astrolemonade/Goose-Belt-Purger/Assets/V2.4/image (1).jpg

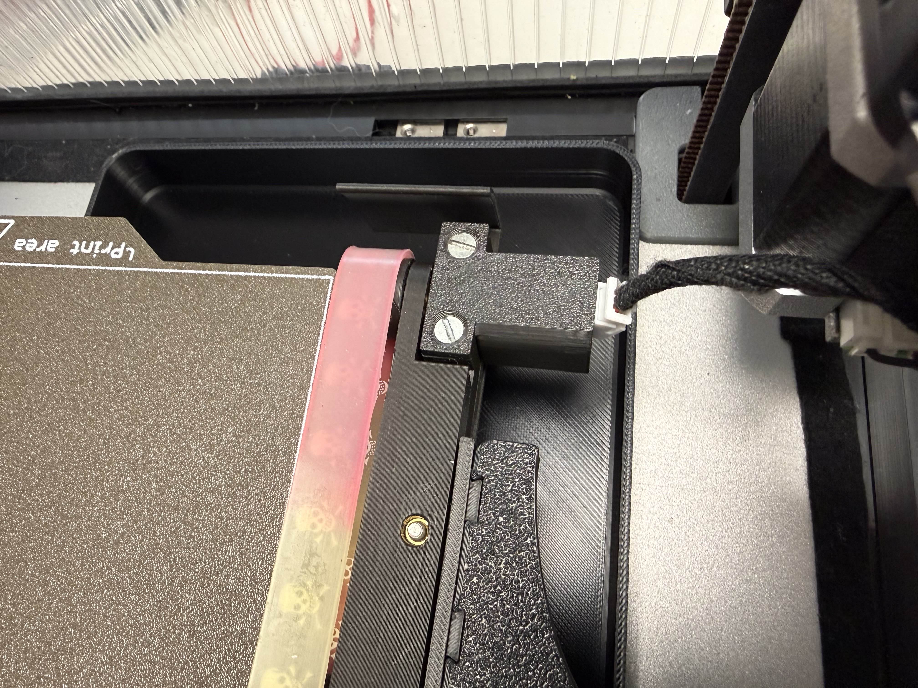
Assets/V2.4/image (1).jpg
