astrolemonade/Goose-Belt-Purger/Assets/V2.4/image (2).jpg

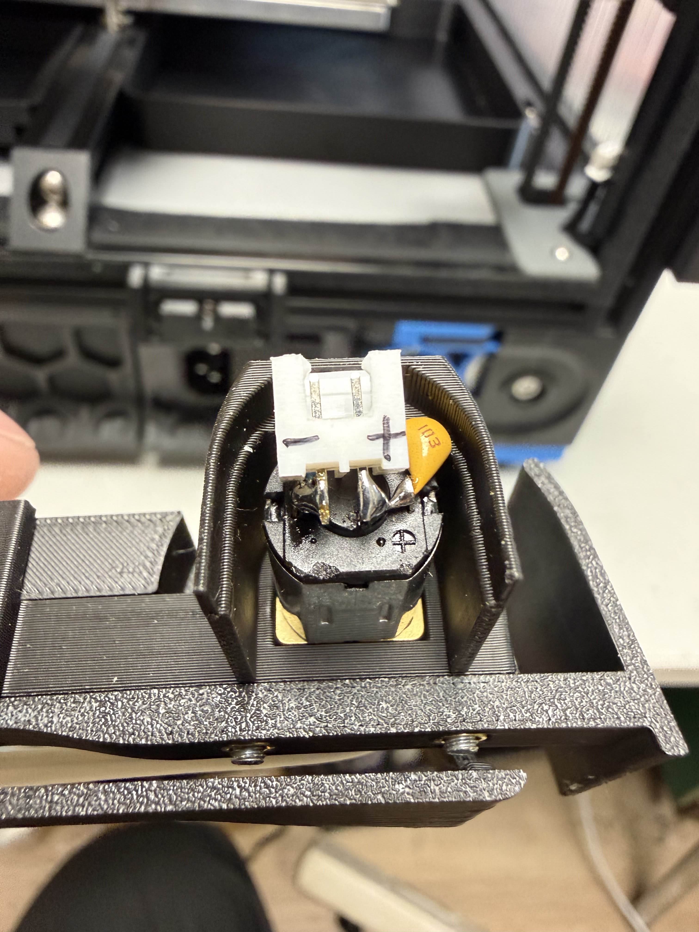
Assets/V2.4/image (2).jpg
