astrolemonade/Goose-Belt-Purger/Assets/V2.4/image (3).jpg

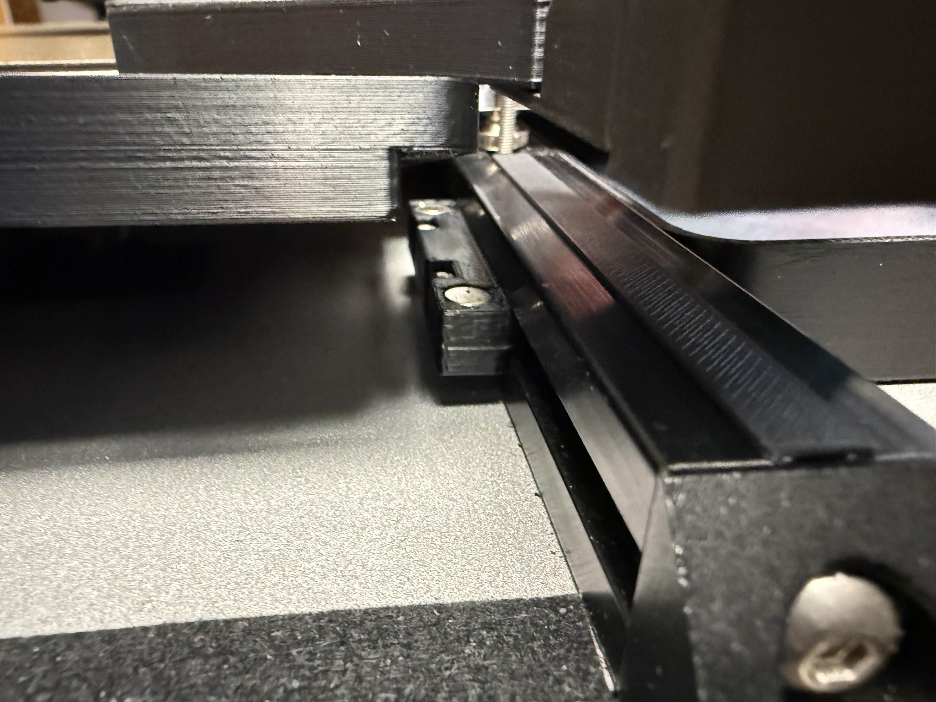
Assets/V2.4/image (3).jpg
