astrolemonade/Goose-Belt-Purger/Assets/V2.4/image (4).jpg

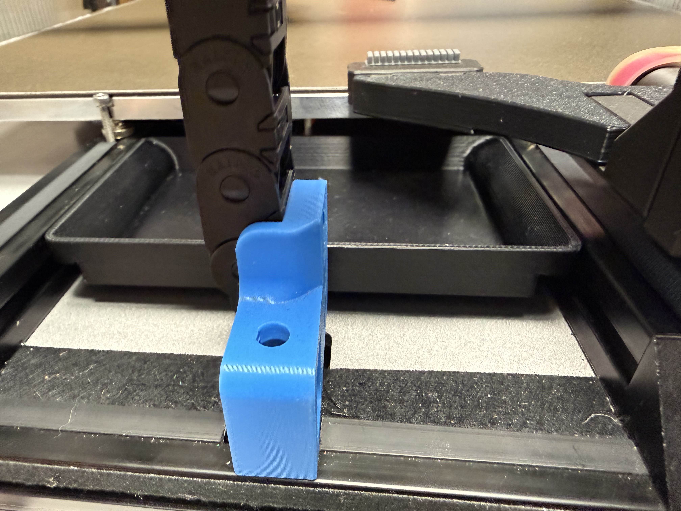
Assets/V2.4/image (4).jpg
