astrolemonade/Goose-Belt-Purger/Assets/V2.4/image (6).jpg

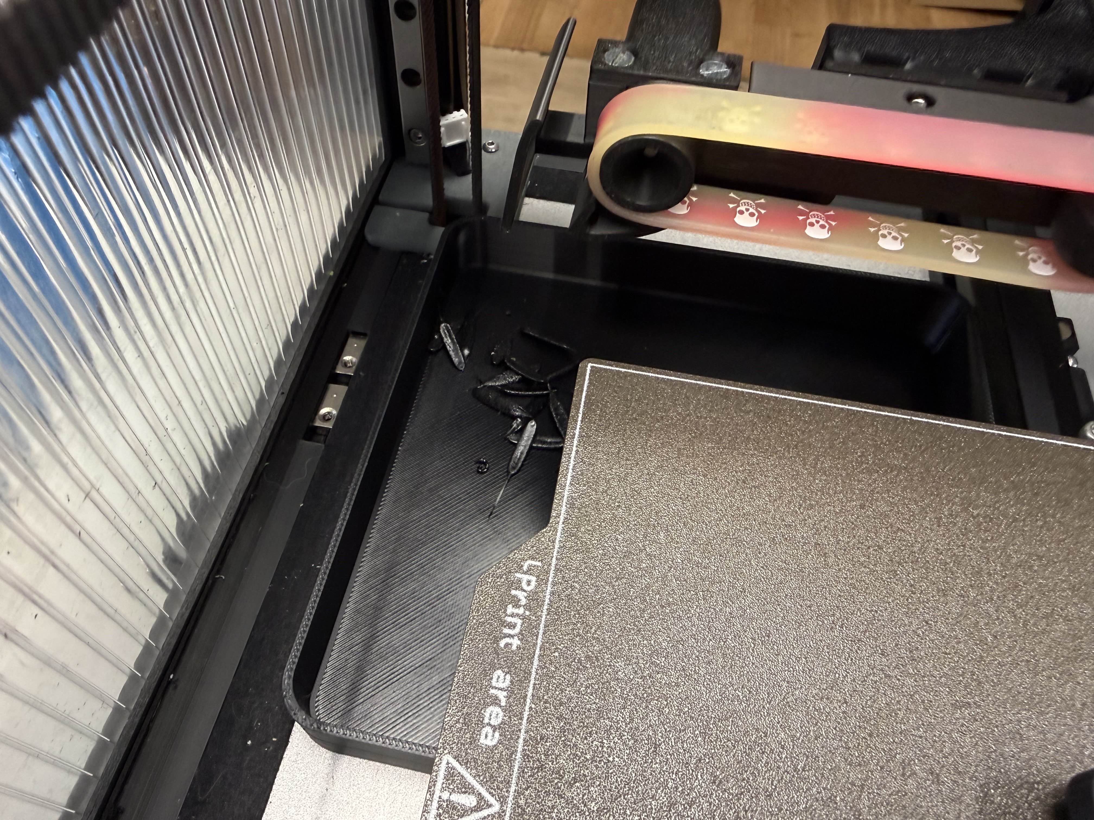
Assets/V2.4/image (6).jpg
