astrolemonade/Goose-Belt-Purger/Assets/V2.4/image (7).jpg

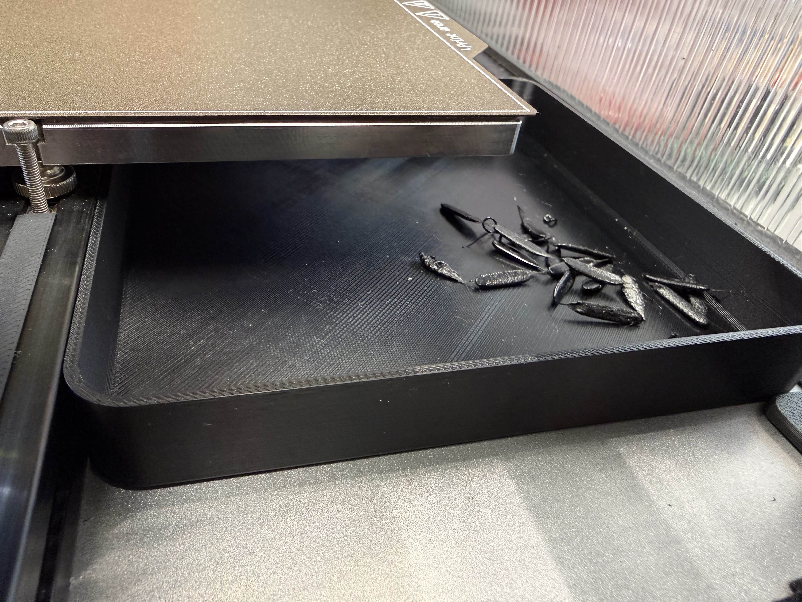
Assets/V2.4/image (7).jpg
