astrolemonade/Goose-Belt-Purger/Assets/V2.4/image (8).jpg

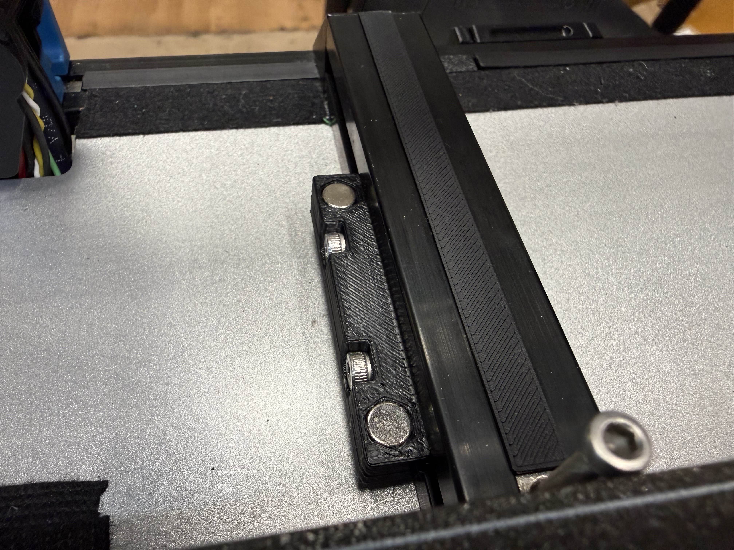
Assets/V2.4/image (8).jpg
