astrolemonade/Goose-Belt-Purger/Assets/V2.4/image (9).jpg

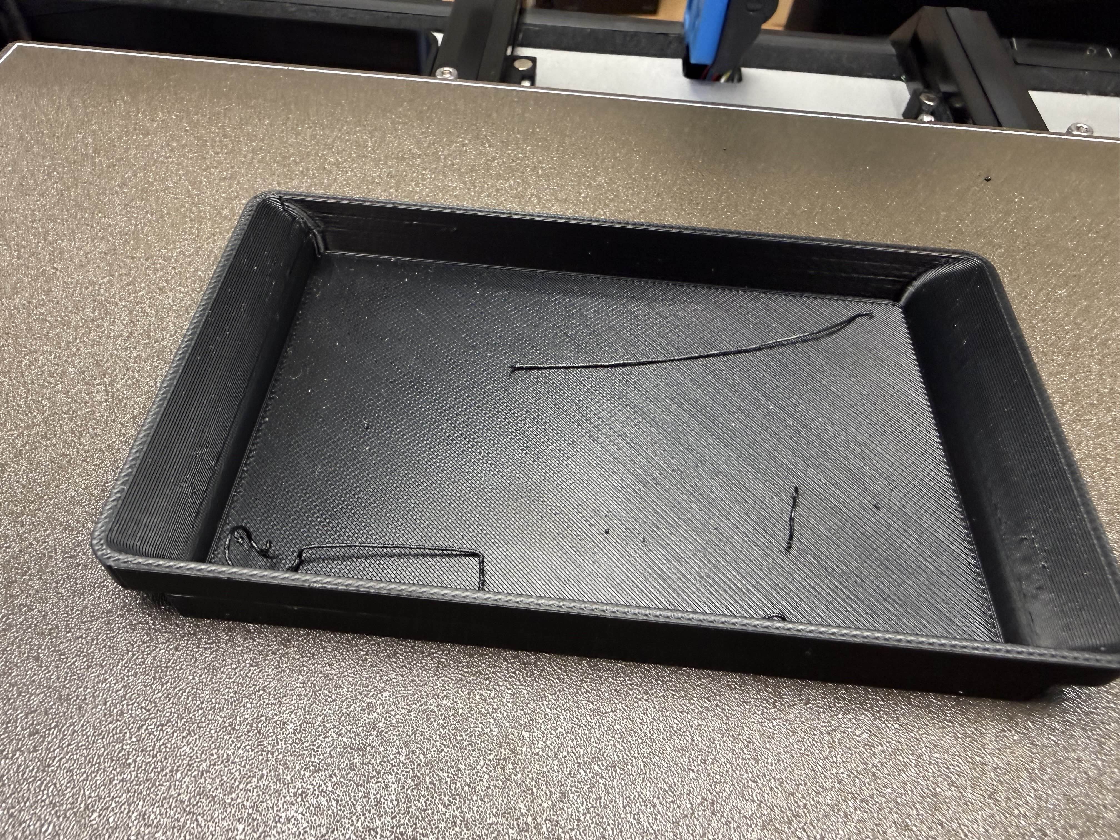
Assets/V2.4/image (9).jpg
