astrolemonade/Goose-Belt-Purger/Assets/V2.4/image (10).jpg

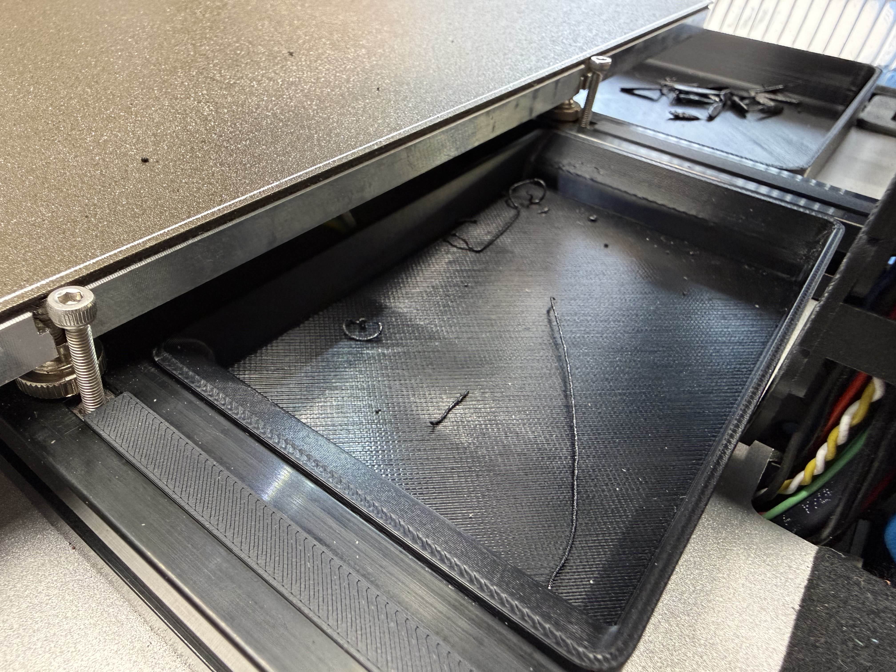
Assets/V2.4/image (10).jpg
