astrolemonade/Goose-Belt-Purger/Assets/V2.4/image.jpg

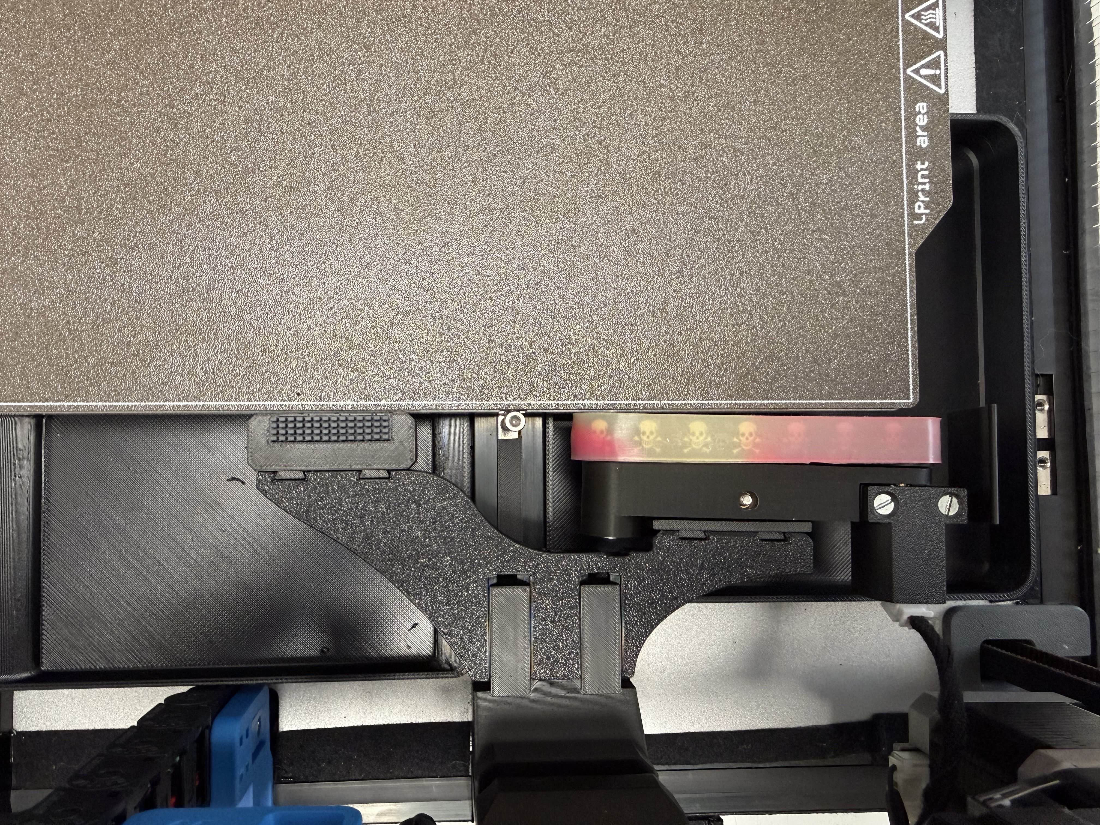
Assets/V2.4/image.jpg
