astrolemonade/Goose-Belt-Purger/User_mods/Dragi2k/Alternative_v2.4_mount/image.png

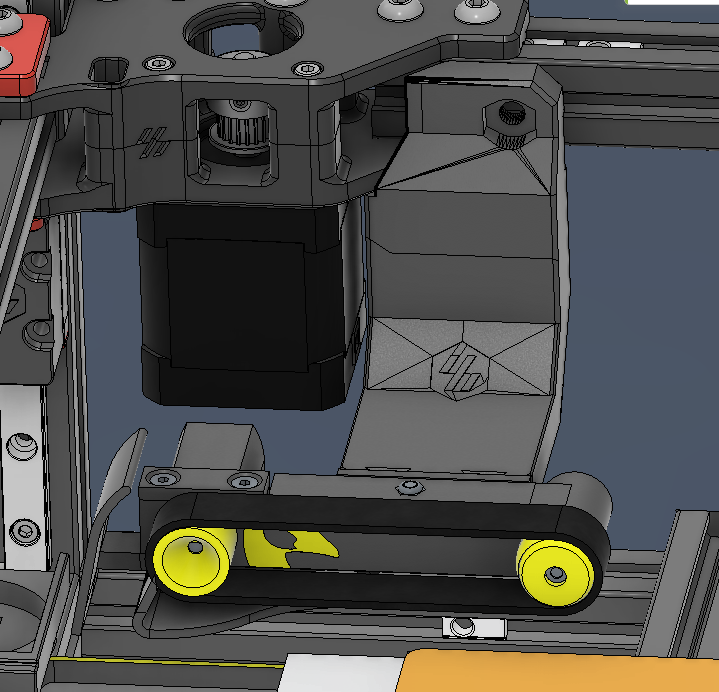
User_mods/Dragi2k/Alternative_v2.4_mount/image.png
