astrolemonade/Goose-Belt-Purger/STEP+STL_(Parts)/STL/01_Mounts/AT_Style-Voron_Trident+2.4/README.md

Modified version of AT Brush mount, suitable for Voron Trident and Voron 2.4.  
  
Based on: AT_Brush (Published under GPL-3) - Credit goes to ArmoredTurtle team

V2.4 offseted mount designed by AmfKuna
