astrolemonade/Goose-Belt-Purger/STEP+STL_(Parts)/STEP/01_Mounts/AT_Style-Voron_Trident+2.4/ATmount_front_arm_slide_V2.4_offset.step

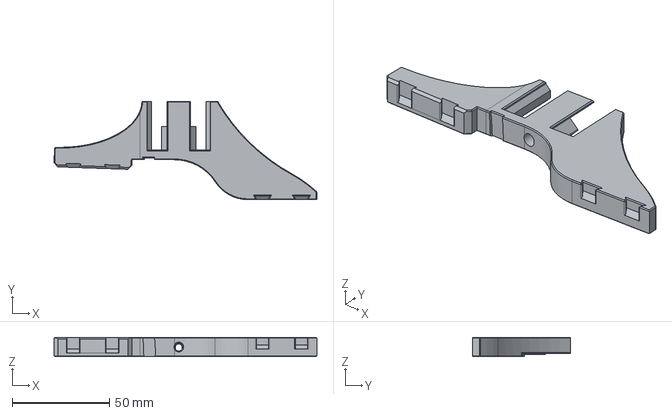
[picture p16: CAD file, 2025-10-19]
STEP+STL_(Parts)/STEP/01_Mounts/AT_Style-Voron_Trident+2.4/ATmount_front_arm_slide_V2.4_offset.step
135.1 x 50.5 x 10.0 mm
