astrolemonade/Goose-Belt-Purger/STEP+STL_(Parts)/STEP/02_Alternative_parts/GBP_Deflector_lite.step

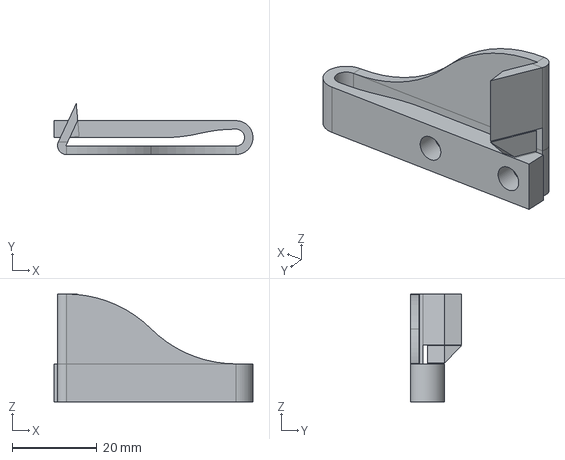
[picture p17: CAD file, 2025-10-06]
STEP+STL_(Parts)/STEP/02_Alternative_parts/GBP_Deflector_lite.step
47.0 x 12.1 x 25.5 mm
