astrolemonade/Goose-Belt-Purger/STEP+STL_(Parts)/STEP/06_Buckets/V2.4_Rear_access/bucket_V2.4-300.step

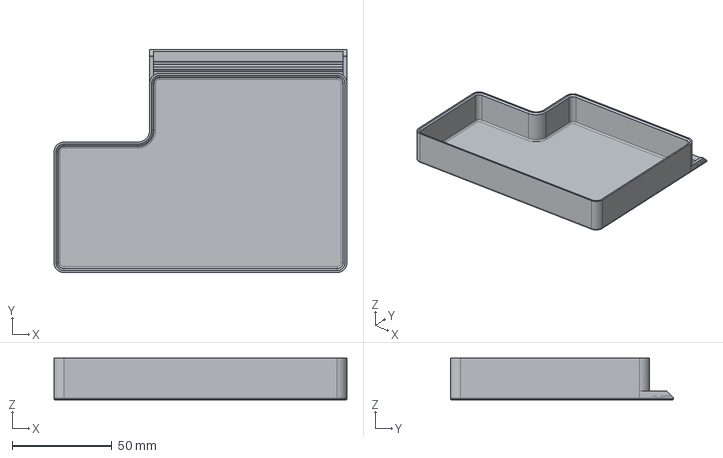
[picture p19: CAD file, 2025-10-06]
STEP+STL_(Parts)/STEP/06_Buckets/V2.4_Rear_access/bucket_V2.4-300.step
147.0 x 112.0 x 21.0 mm
