astrolemonade/Goose-Belt-Purger/STEP+STL_(Parts)/STEP/GBP_Deflector.step

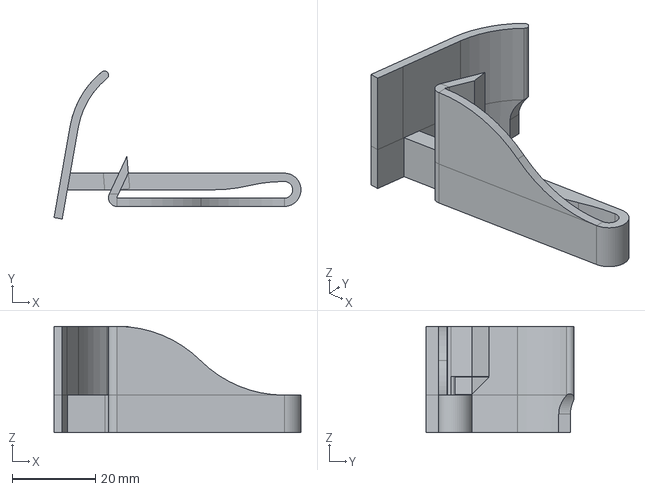
[picture p20: CAD file, 2025-10-06]
STEP+STL_(Parts)/STEP/GBP_Deflector.step
59.2 x 35.5 x 25.5 mm
