astrolemonade/Goose-Belt-Purger/STEP+STL_(Parts)/STL/01_Mounts/AT_Style-Voron_Trident+2.4/ATmount_front_arm_base_(GBP).stl

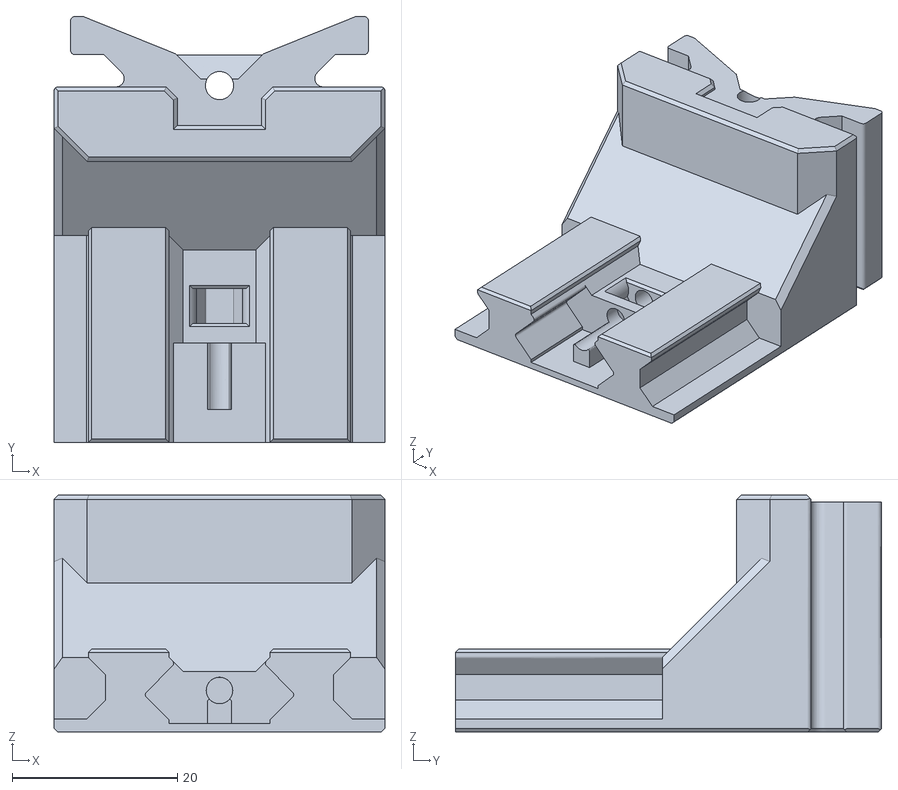
[picture p21: CAD file, 2025-10-06]
STEP+STL_(Parts)/STL/01_Mounts/AT_Style-Voron_Trident+2.4/ATmount_front_arm_base_(GBP).stl
40.0 x 51.5 x 28.6
