astrolemonade/Goose-Belt-Purger/STEP+STL_(Parts)/STL/06_Buckets/V2.4/V2.4_Center/center_bucket.stl

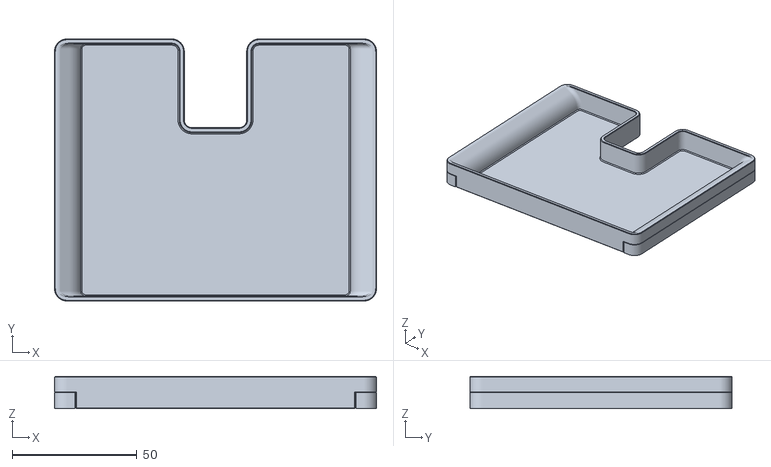
[picture p22: CAD file, 2025-10-19]
STEP+STL_(Parts)/STL/06_Buckets/V2.4/V2.4_Center/center_bucket.stl
129.0 x 105.0 x 13.0
