astrolemonade/Goose-Belt-Purger/STEP+STL_(Parts)/STL/06_Buckets/V2.4_Front_access/GBP_bucket_V2.4-300_front.stl

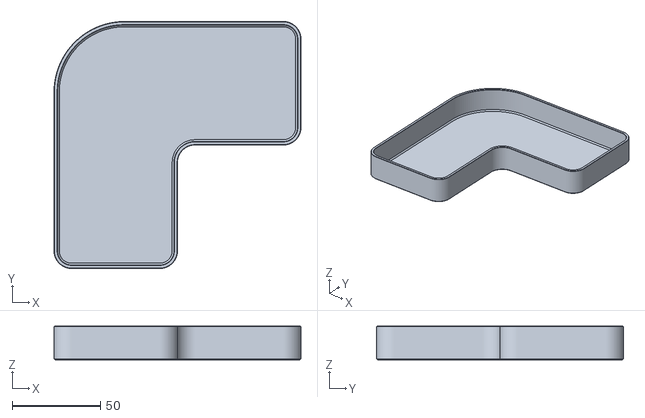
[picture p23: CAD file, 2025-10-06]
STEP+STL_(Parts)/STL/06_Buckets/V2.4_Front_access/GBP_bucket_V2.4-300_front.stl
140.0 x 140.0 x 19.0
