astrolemonade/Goose-Belt-Purger/User_mods/Dragi2k/Alternative_v2.4_mount/V2.4 AT mount side mod.stl

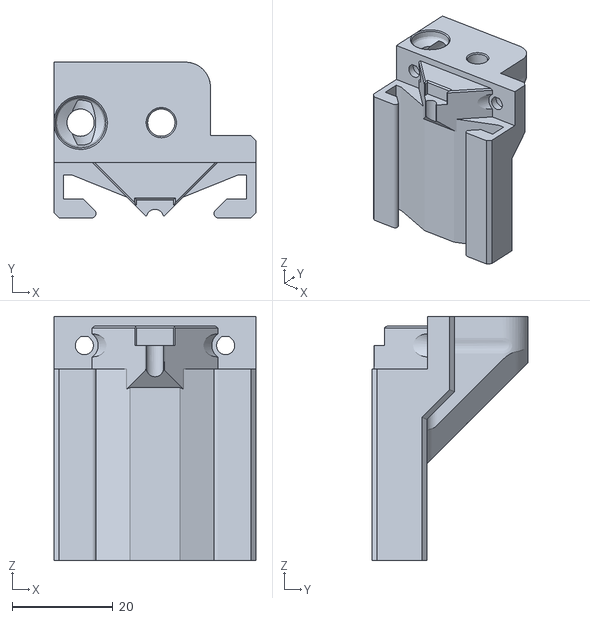
[picture p24: CAD file, 2025-10-19]
User_mods/Dragi2k/Alternative_v2.4_mount/V2.4 AT mount side mod.stl
40.0 x 30.9 x 48.4
