astrolemonade/Goose-Belt-Purger/User_mods/Sakitume/MotorPulley/GBP_Motor_Pulley_4mmBHCS.stl

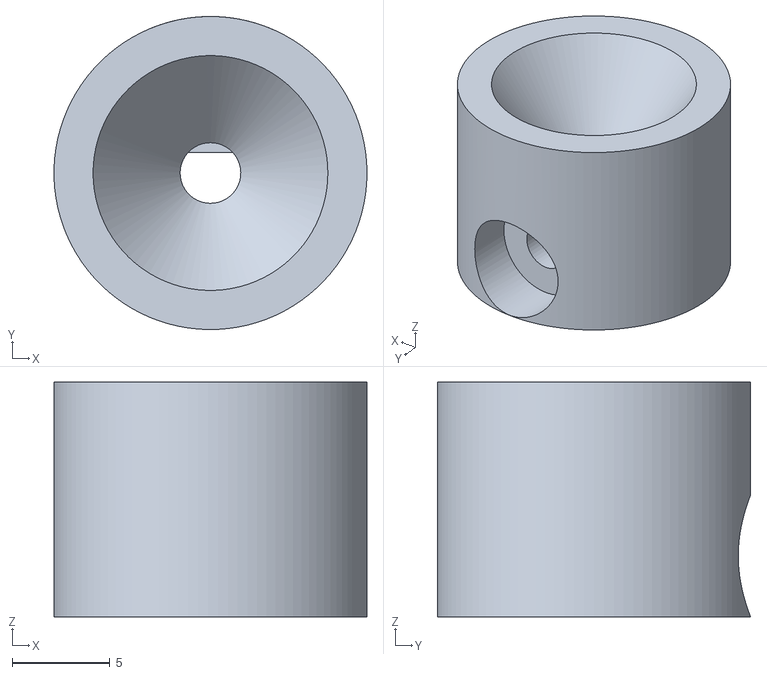
[picture p25: CAD file, 2025-12-23]
User_mods/Sakitume/MotorPulley/GBP_Motor_Pulley_4mmBHCS.stl
16.0 x 16.0 x 12.0
