astrolemonade/Goose-Belt-Purger/User_mods/Sakitume/TPU_Belt/Deflector_short_thin_belt.stl

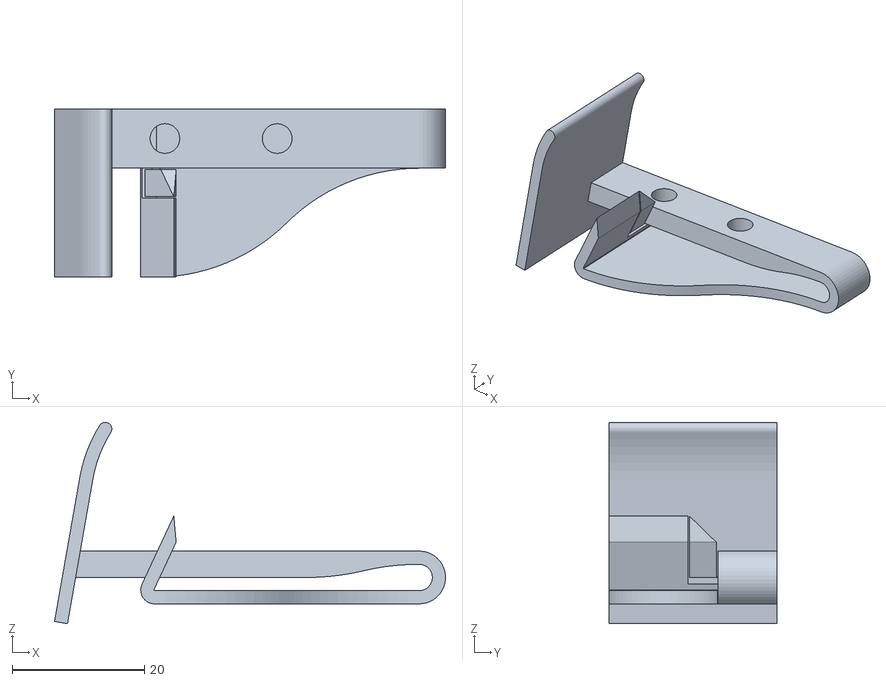
[picture p26: CAD file, 2025-12-23]
User_mods/Sakitume/TPU_Belt/Deflector_short_thin_belt.stl
59.2 x 25.5 x 30.5
