astrolemonade/Goose-Belt-Purger/STEP+STL_(Parts)/STEP/01_Mounts/AT_Style-Voron_Trident+2.4/ATmount_front_arm_slide_Trident_offset.step

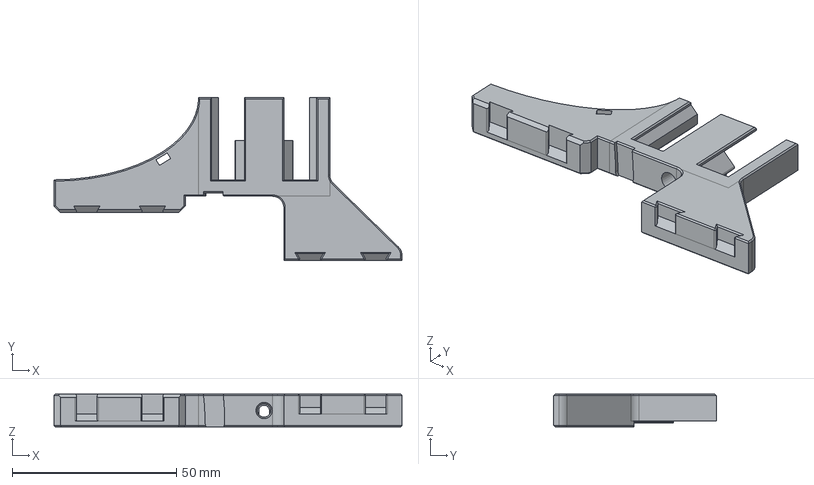
[picture p27: CAD file, 2025-10-06]
STEP+STL_(Parts)/STEP/01_Mounts/AT_Style-Voron_Trident+2.4/ATmount_front_arm_slide_Trident_offset.step
106.0 x 49.5 x 10.0 mm
