astrolemonade/Goose-Belt-Purger/STEP+STL_(Parts)/STEP/06_Buckets/Trident/bucket_Trident-350.step

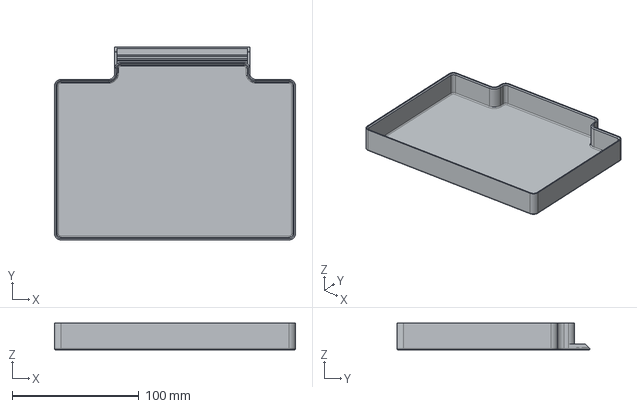
[picture p28: CAD file, 2025-10-06]
STEP+STL_(Parts)/STEP/06_Buckets/Trident/bucket_Trident-350.step
190.0 x 152.0 x 21.0 mm
