astrolemonade/Goose-Belt-Purger/STEP+STL_(Parts)/STL/01_Mounts/AT_Style-Voron_Trident+2.4/ATmount_lower_(GBP).stl

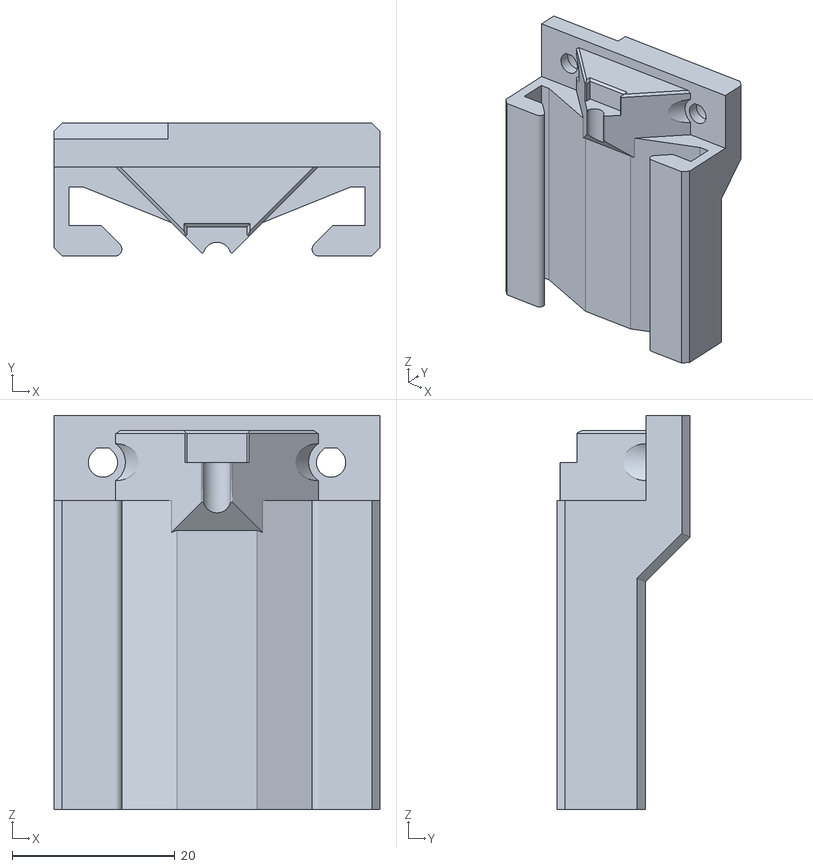
[picture p29: CAD file, 2025-10-06]
STEP+STL_(Parts)/STL/01_Mounts/AT_Style-Voron_Trident+2.4/ATmount_lower_(GBP).stl
40.0 x 16.4 x 48.4
