astrolemonade/Goose-Belt-Purger/STEP+STL_(Parts)/STL/06_Buckets/V2.4_Front_access/GBP_bucket_V2.4-250_front.stl

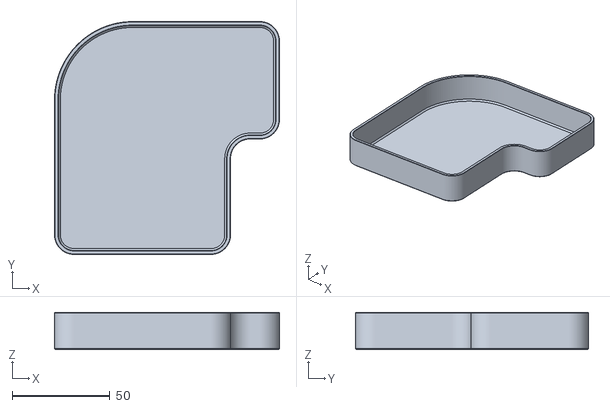
[picture p30: CAD file, 2025-10-06]
STEP+STL_(Parts)/STL/06_Buckets/V2.4_Front_access/GBP_bucket_V2.4-250_front.stl
115.0 x 119.0 x 19.0
