astrolemonade/Goose-Belt-Purger/User_mods/Dragi2k/Alternative_v2.4_mount/300 v2.4 with xol FIX.stl

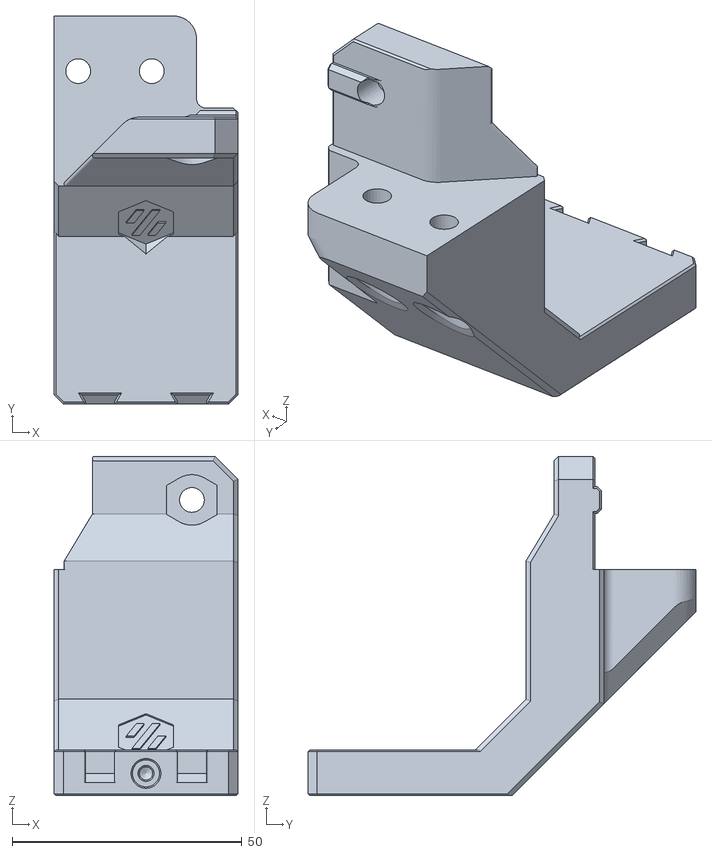
[picture p31: CAD file, 2025-10-19]
User_mods/Dragi2k/Alternative_v2.4_mount/300 v2.4 with xol FIX.stl
40.0 x 84.4 x 73.9
