astrolemonade/Goose-Belt-Purger/User_mods/Sakitume/TPU_Belt/TPU_Belt.stl

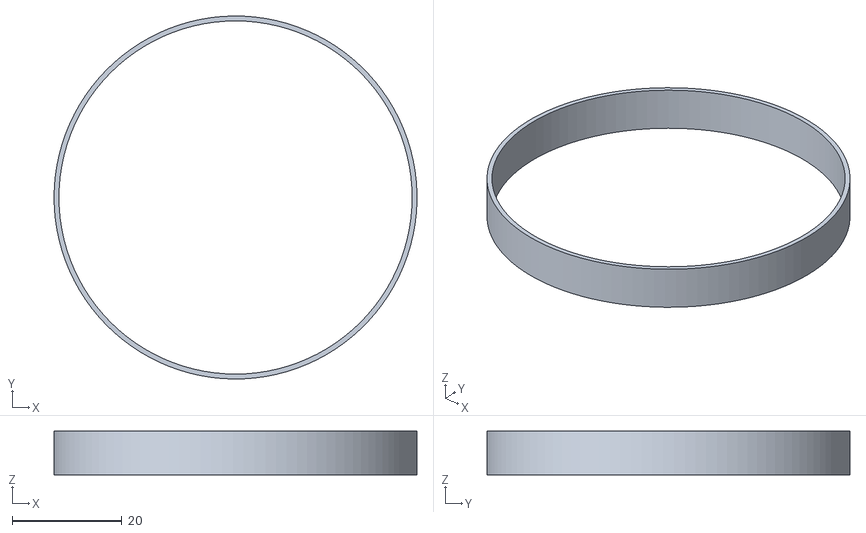
[picture p32: CAD file, 2025-12-23]
User_mods/Sakitume/TPU_Belt/TPU_Belt.stl
66.1 x 66.1 x 8.00
