astrolemonade/Goose-Belt-Purger/STEP+STL_(Parts)/STEP/02_Alternative_parts/GBP_Deflector_long_noinserts.step

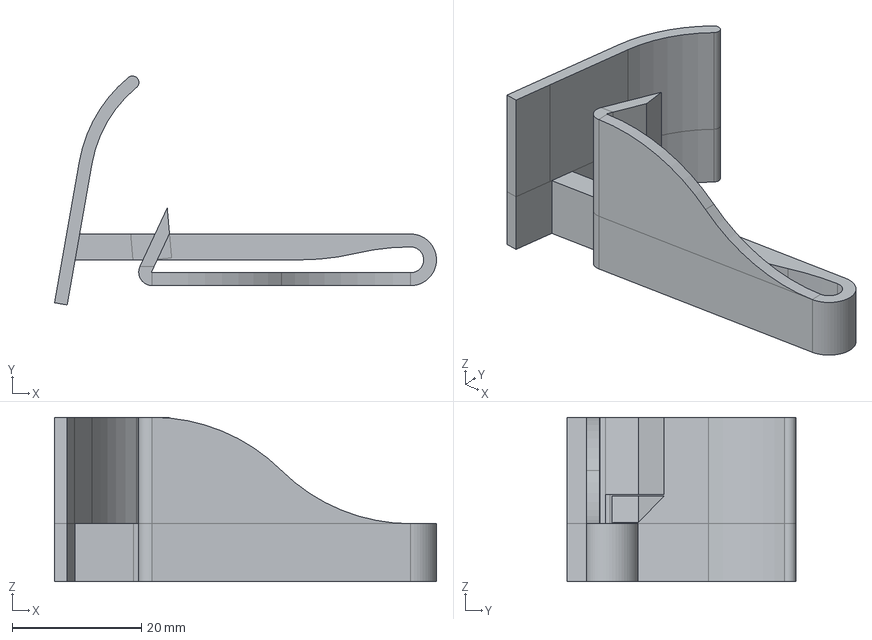
[picture p33: CAD file, 2025-10-06]
STEP+STL_(Parts)/STEP/02_Alternative_parts/GBP_Deflector_long_noinserts.step
59.2 x 35.5 x 25.5 mm
