astrolemonade/Goose-Belt-Purger/STEP+STL_(Parts)/STEP/06_Buckets/Trident/bucket_clamp_(FHCS)_x2.step

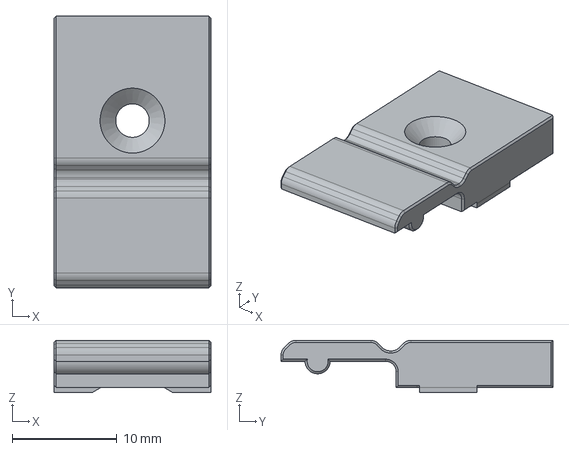
[picture p34: CAD file, 2025-10-06]
STEP+STL_(Parts)/STEP/06_Buckets/Trident/bucket_clamp_(FHCS)_x2.step
15.0 x 26.0 x 5.00 mm
