astrolemonade/Goose-Belt-Purger/STEP+STL_(Parts)/STL/01_Mounts/AT_Style-Voron_Trident+2.4/ATmount_front_arm_slide_(GBP).stl

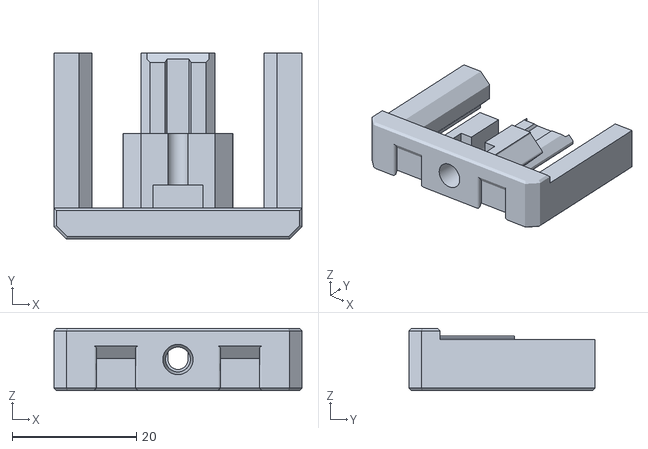
[picture p36: CAD file, 2025-10-06]
STEP+STL_(Parts)/STL/01_Mounts/AT_Style-Voron_Trident+2.4/ATmount_front_arm_slide_(GBP).stl
40.0 x 30.0 x 10.0
