astrolemonade/Goose-Belt-Purger/STEP+STL_(Parts)/STL/01_Mounts/AT_Style-Voron_Trident+2.4/ATmount_upper_(GBP).stl

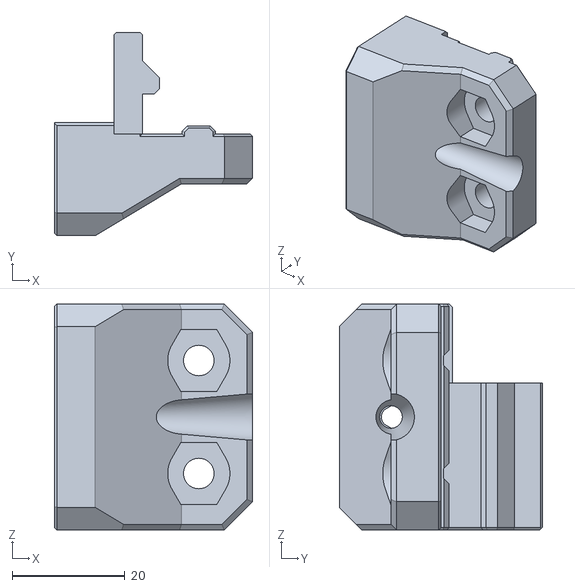
[picture p38: CAD file, 2025-10-06]
STEP+STL_(Parts)/STL/01_Mounts/AT_Style-Voron_Trident+2.4/ATmount_upper_(GBP).stl
35.0 x 36.0 x 40.0
