astrolemonade/Goose-Belt-Purger/STEP+STL_(Parts)/STEP/02_Alternative_parts/GBP_Deflector_short.step

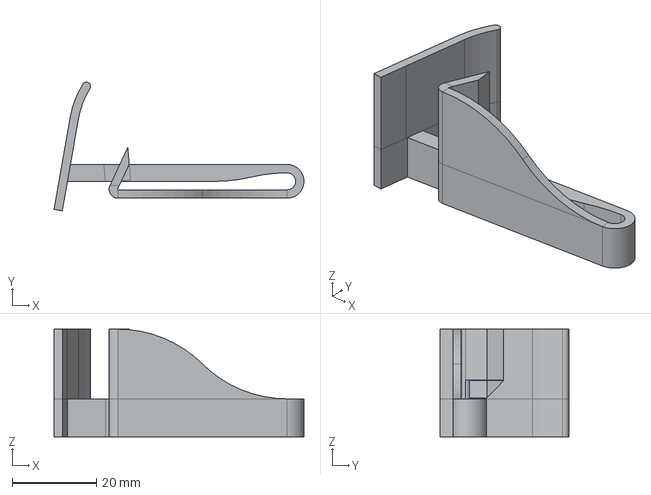
[picture p39: CAD file, 2025-10-06]
STEP+STL_(Parts)/STEP/02_Alternative_parts/GBP_Deflector_short.step
59.2 x 30.5 x 25.5 mm
