astrolemonade/Goose-Belt-Purger/STEP+STL_(Parts)/STEP/06_Buckets/Trident/bucket_Trident-250.step

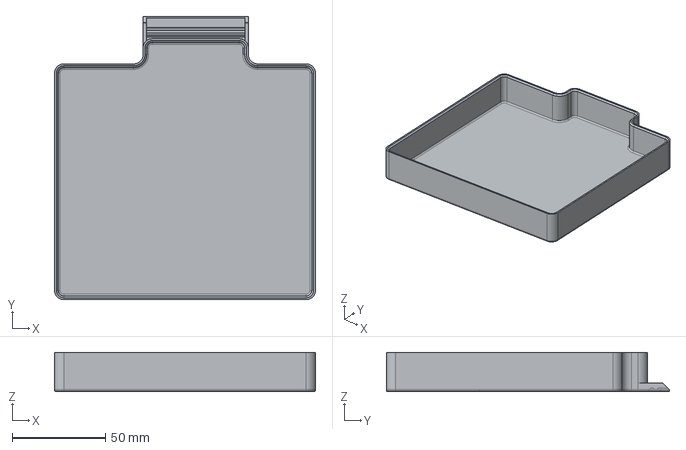
[picture p40: CAD file, 2025-10-06]
STEP+STL_(Parts)/STEP/06_Buckets/Trident/bucket_Trident-250.step
140.0 x 152.0 x 21.0 mm
