astrolemonade/Goose-Belt-Purger/(list of files, cad)

Other CAD files:
STEP+STL_(Parts)/STEP/02_Alternative_parts/GBP_Deflector_lite_noinserts.step
STEP+STL_(Parts)/STEP/06_Buckets/Trident/bucket_clamp_x2.step
STEP+STL_(Parts)/STEP/06_Buckets/V2.4_Rear_access/bucket_clamp_x2.step
STEP+STL_(Parts)/STEP/02_Alternative_parts/GBP_Deflector_short_noinserts.step
STEP+STL_(Parts)/STEP/06_Buckets/V2.4_Rear_access/bucket_V2.4_250.stl
STEP+STL_(Parts)/STEP/06_Buckets/V2.4_Rear_access/bucket_V2.4_300.stl
STEP+STL_(Parts)/STEP/06_Buckets/V2.4_Rear_access/bucket_V2.4_350.stl
STEP+STL_(Parts)/STEP/06_Buckets/V2.4_Rear_access/bucket_V2.stl
STEP+STL_(Parts)/STEP/06_Buckets/V2.4_Rear_access/bucket_clamp_(FHCS)_x2.stl
STEP+STL_(Parts)/STEP/06_Buckets/V2.4_Rear_access/bucket_clamp_x2.stl
STEP+STL_(Parts)/STL/01_Mounts/AT_Style-Voron_Trident+2.4/ATmount_front_arm_slide_Trident_offset.stl
STEP+STL_(Parts)/STL/01_Mounts/AT_Style-Voron_Trident+2.4/ATmount_front_arm_slide_V2.4_offset.stl
STEP+STL_(Parts)/STL/02_Alternative_parts/GBP_Deflector_lite.stl
STEP+STL_(Parts)/STL/02_Alternative_parts/GBP_Deflector_lite_noinserts.stl
STEP+STL_(Parts)/STL/02_Alternative_parts/GBP_Deflector_long.stl
STEP+STL_(Parts)/STL/02_Alternative_parts/GBP_Deflector_long_noinserts.stl
STEP+STL_(Parts)/STL/02_Alternative_parts/GBP_Deflector_short.stl
STEP+STL_(Parts)/STL/02_Alternative_parts/GBP_Deflector_short_noinserts.stl
STEP+STL_(Parts)/STL/06_Buckets/Trident/bucket_Trident-250.stl
STEP+STL_(Parts)/STL/06_Buckets/Trident/bucket_Trident-300.stl
STEP+STL_(Parts)/STL/06_Buckets/Trident/bucket_Trident-350.stl
STEP+STL_(Parts)/STL/06_Buckets/Trident/bucket_clamp_(FHCS)_x2.stl
STEP+STL_(Parts)/STL/06_Buckets/Trident/bucket_clamp_x2.stl
STEP+STL_(Parts)/STL/06_Buckets/V2.4_Rear_access/bucket_V2.4_250.stl
STEP+STL_(Parts)/STL/06_Buckets/V2.4_Rear_access/bucket_V2.4_300.stl
STEP+STL_(Parts)/STL/06_Buckets/V2.4_Rear_access/bucket_V2.4_350.stl
STEP+STL_(Parts)/STL/06_Buckets/V2.4_Rear_access/bucket_clamp_(FHCS)_x2.stl
STEP+STL_(Parts)/STL/06_Buckets/V2.4_Rear_access/bucket_clamp_x2.stl
STEP+STL_(Parts)/STL/GBP_Deflector.stl
User_mods/Sakitume/MotorPulley/GBP_Motor_Pulley_4mmBHCS.f3d
User_mods/Sakitume/TPU_Belt/TPU_Belt.f3d
