astrolemonade/Goose-Belt-Purger/(commit log)

2025-10-06 a012 upload
    [ATmount_front_arm_base_(GBP).stl, ATmount_front_arm_slide_(GBP).stl, ATmount_front_arm_slide_Trident_offseted.step, ATmount_front_arm_slide_Trident_offseted.stl, ATmount_front_arm_slide_V2.4_offseted.stl, ATmount_front_arm_slide_offseted_am04.step, ATmount_lower_(GBP).stl, ATmount_upper_(GBP).stl]
2025-10-10 removal of extra files
    [bucket_Trident-250.stl, bucket_Trident-300.stl, bucket_Trident-350.stl, bucket_V2.4_250.stl, bucket_V2.4_300.stl, bucket_V2.4_350.stl, bucket_V2.stl, bucket_clamp_(FHCS)_x2.stl]
2025-12-10 0.7.3-beta-1
    - Added kickstart
    - Enhanced comments regarding belt_pwm variable
    - Fix: Possible logic bug in purge macro #15
    [goose_belt.cfg]
2025-12-10 Enhance sw_configuration.md with user guidance
    Added sections on staging and purging positions, motor PWM configuration, and advanced slicer configuration for better user guidance.
2025-12-11 Initial commit of some of my mods
    [Deflector_short_thin_belt.stl, GBP_Motor_Pulley_4mmBHCS.f3d, GBP_Motor_Pulley_4mmBHCS.stl, TPU_Belt.f3d, TPU_Belt.stl]
2025-12-23 macro v0.7.3
    [goose_belt.cfg]
2025-12-23 Update configuration details and version to 0.7.3
    Updated version reference and added details on output pin definition and Happy Hare integration.
2025-12-23 User_mods folder update
    [300 v2.4 with xol FIX.stl, V2.4 AT mount side mod.stl, belt_purger_a011 v20.step]
